xiaoxufeifei/ECG-acquisition-circuit-NJU-ee-project/ECG_AFE_可行性设计.md

# 心电信号放大电路：任务识别、可行性设计与验收方案

## 1. 图片中的任务要求

任务是设计并制作一套心电信号模拟前端，滤除心电频带以外的干扰，把微弱差模心电信号送入 0–3.3 V 单片机 ADC。硬性指标如下：

- 输入阻抗：不低于 5 MΩ；
- 共模抑制比：不低于 80 dB；
- 频带：0.2–90 Hz；低端低于 0.2 Hz 可加分，最低计到 0.05 Hz；高端允许误差 ±5%；
- 差模增益：1500 倍；
- 芯片只能选 OP07、LM358、TL084；
- 运放单元不超过 12 个，滑动变阻器不超过 4 个；
- 需要 50 Hz 陷波器，要求 3<Q<3.5；
- 输出要加直流偏置后送入 0–3.3 V ADC；
- 右腿驱动属于加分设计；
- R、C 都必须选标称值，不能直接填写计算所得的任意数值；电容不大于 1 µF；先选电容、再计算电阻；非标称电阻用标称电阻串、并联实现；
- 除电源电压外，1.65 V 等所有偏置电压都必须由板上相应电路产生，不能另接外部直流源；
- 高通必须放在仪用放大器之后，用于隔离电极极化电压；
- 先弄清原理再计算；仿真验收项目明确包括输入阻抗、差模增益和带宽。之后完成原理图和 PCB、设计验收、制板、焊接调试、信号源及心电模拟器实物验收；必须先通过设计验收再投板。课件原文为“10 月 16 日一阶段结束”（结合 2026-8-28 页脚可推定为 2026 年，但该页未单独写年份）。

## 2. 可行性结论与边界

从指标和允许器件看，任务具有可行性。以下是进入 EDA 前的可行性草案：采用 ±15 V 模拟电源和单片机的 3.3 V 电源，使用 11 个运放单元、4 个多圈微调电阻。10 Hz 端子到输出增益可校准为 1500.000，计算的整体 -3 dB 频带为 0.176–90.425 Hz，50 Hz 陷波 Q 为 3.252。OP07 的输出摆幅等关键指标在 ±15 V 条件下有数据手册保证；在完成厂商宏模型仿真、极限工况分析和教师设计验收前，本草案不能直接投板。

总增益 1500 与 0–3.3 V 范围共同决定了输入幅度上限。输出以约 1.65 V 为中心时，理论无削顶差模输入为 ±1.10 mV；考虑失调和容差，建议验收时把心电模拟器峰值限制在 ±1.00 mV以内。若模拟器幅度更大而又必须保持 1500 倍，0–3.3 V 输出必然削顶，这是指标本身的数学边界，不是换一种电路就能消除的。

本方案只用于隔离信号源和心电模拟器。它没有医疗隔离、除颤保护和患者漏电流认证，不能直接连接人体。

## 3. 总体信号链

```text
LA/RA 输入
  │  每路 100 kΩ 限流、10 MΩ 偏置；两路之间 47 pF 差模射频电容
  ▼
三 OP07 仪用放大器，Ad = 25
  ▼
820 nF + 1.1 MΩ 高通，fc = 0.176 Hz
  ▼
TL084 同相可调增益，A ≈ 23.58
  ▼
两运放 Fliege 50 Hz 陷波，Q = 3.252，A = 1
  ▼
四阶 Butterworth Sallen-Key 低通
  ├─ 第 1 节：Q = 0.5405，K = 1.15
  └─ 第 2 节：Q = 1.3158，K = 2.24
  ▼
OP07 电平抬升：VADC = VAC + VREF
  ▼
4.7 kΩ 隔离 + 3.3 V/0 V 钳位 + 10 nF ADC 储能电容
```

首级两路输出的平均共模同时送入独立 OP07 右腿驱动；3.3 V 经微调分压及 OP07 缓冲生成 VREF。

## 4. 运放与微调数量

| 器件 | 单元用途 | 单元数 |
|---|---|---:|
| OP07 ×3 | 三运放仪放 | 3 |
| TL084 ×1 | 高通后增益、Fliege 两单元、低通第 1 节 | 4 |
| OP07 ×2 | 低通第 2 节、ADC 电平抬升 | 2 |
| OP07 ×1 | 1.65 V 可调参考缓冲 | 1 |
| OP07 ×1 | 右腿驱动 | 1 |
| **合计** |  | **11** |

四个微调器分别用于 CMRR、总增益、50 Hz 中心频率和 ADC 静态中心电压，恰好不超过限制。

课件写的是“芯片范围：OP07、LM358、TL084”，即只能从三类中选，并未要求三类都要使用。LM358 曾作为后级候选，但 ±15 V 双电源已经等于它的 30 V 总工作电压上限，无法覆盖电源正向容差；其失调和 CMRR 也弱于 OP07。因此最终不用 LM358，以两个 OP07 代替，单元总数不变且可以统一供电。

## 5. 逐级电路及元件值

### 5.1 电源、地与输入保护

- OP07 和 TL084 都由 ±15 V 供电；Multisim 还要覆盖 ±5% 电源变化。最终 OP07 输出正常工作在 0.15–3.15 V 附近，远离两条供电轨，不依赖轨到轨能力。
- 每个 IC 的正、负电源脚各放一个 100 nF 陶瓷电容到模拟地，距离引脚尽量小于 5 mm；板上电源入口每条电源轨再放 1 µF，所有电容均不超过 1 µF。课件说明实验室提供的 1 µF 及以上电容均为有极性电解电容，因此这里的 1 µF 必须按有极性器件处理：+15 V 侧正端接 +15 V、负端接地；-15 V 侧正端接地、负端接 -15 V，原理图和 PCB 都必须标出极性。
- LA、RA 各串 100 kΩ 后进入仪放；每个运放正输入接 10 MΩ 到模拟地；两个 100 kΩ 之后的输入节点之间接一只 47 pF C0G/NP0。不要各自对地放射频电容，因为两只小电容的失配会直接把共模变成差模。
- 两只 100 kΩ 使用实验室清单中的 0.1% 精密电阻，但不能只凭“0.1%”标称就视为已经配对：焊接前仍须实测筛选，使两只 100 kΩ 的相对误差不大于 0.05%。清单没有 10 MΩ 精密值，因此两只 10 MΩ 保留同批次低温漂金属膜并同样实测筛选，成对相对误差不大于 0.05%；若现有测量条件不能可靠完成 10 MΩ 配对，应另行采购匹配件，不能用大量 100 kΩ 串联代替。在 90 Hz、另一输入交流接地的保守测量条件下，每个端口的输入阻抗约 9.7 MΩ，仍明显高于 5 MΩ。
- 四个输入电阻完全镜像布置，47 pF 跨接在两路节点之间且走线尽量短。这个匹配条件是板级 CMRR 的组成部分，不能只依赖 OP07 自身的 CMRR。

### 5.2 三 OP07 仪用放大器

本节改用老师提供的 0.1% 精密电阻库存。以下只使用贴片和直插清单中都具备的 10 kΩ、30 kΩ；同一组匹配网络必须统一使用同一种封装，不能把 0805 与直插混装。

前两个 OP07 构成经典仪放输入级：

- 两个反馈电阻各使用一只 30.0 kΩ、0.1% 精密电阻；
- 两个反相端之间的增益电阻由四只 10.0 kΩ、0.1% 精密电阻并联，等效为 2.50 kΩ；四只器件应靠近、等长连接；
- 输入级差模增益：

```text
Rg = 10 kΩ || 10 kΩ || 10 kΩ || 10 kΩ = 2.50 kΩ
A1 = 1 + (30 kΩ + 30 kΩ) / 2.50 kΩ = 25
```

第三个 OP07 构成标称单位增益差分放大器：

- 定义 R1 为前级输出到反相端、R2 为输出到反相端反馈、R3 为另一路前级输出到同相端、R4 为同相端到地；R1、R2、R3、R4 的固定部分全部使用 10.0 kΩ、0.1% 精密电阻；
- `P_CMRR` 仍为 200 Ω 十圈微调器，作为变阻器串在 R4 与地之间。焊接前实测四只 10 kΩ 并按 `Ra≤Rb≤Rc≤Rd` 排序：R4 固定部分用 Ra、R3 用 Rb、R1 用 Rc、R2 用 Rd。由 `R4总值=R3×R2/R1` 可知所需补偿为非负值；对 0.1% 的 10 kΩ，理论补偿量不超过 20 Ω，因此 0–200 Ω 的上限足够。初次上电先把 `P_CMRR` 调到接近最小值；
- 200 Ω 微调器实际可能存在非零端电阻。焊接前要测出其可达下限，并通过重选或调换四只 10 kΩ，使计算出的补偿量落在实际可调区间内；若调到下限后实测 CMRR 已达标，则不必追求数学上的绝对 0 Ω。在线调 CMRR 时，万用表应能分辨数欧姆以内的变化；
- 微调器作变阻器使用时，滑臂必须与相邻端短接，避免滑臂瞬断使环路开路。

OP07 的低失调、低漂移和高 CMRR 适合这一位置。精密电阻替换后，理想输入级增益仍为 25；`P_CMRR` 调节的是 `R4总值/R3=R2/R1`，从而使两臂比例相等并抑制共模，而不是把差模增益强制调成 1。名义差模增益为 1，按上述排序后的实物差模增益 `R2/R1` 约为 1～1.002，残余总增益误差由后级 `P_GAIN` 校准，因此标称频响结构不变。30 kΩ/2.5 kΩ 相比原 12 kΩ/1 kΩ 把阻抗尺度提高了 2.5 倍，会略增加电阻热噪声和偏置电流造成的输出误差；最终仍须在厂商宏模型和短路输入噪声测试中复核。输入级增益 25 也会把末级差分电阻的残余共模误差折算降低约 28 dB。仪放输出之后才进入高通，符合课件要求。

> 本轮按要求只更新第 5 章原理图。第 2、3 章摘要、第 6 章及其后的验证结果、验证脚本仍保留旧电阻模型，不能视为对本替换方案的重新仿真结论；投板前应另行同步模型并复跑验证。

### 5.3 0.176 Hz 高通与可调增益

- 仪放输出串 820 nF、2% 薄膜电容；
- 电容后节点接 1.10 MΩ、1% 到模拟地，并接 TL084 的同相输入。该阻值不在精密库存内；若用库存值实现需要串联 11 只 100 kΩ，焊点、漏电和寄生风险大于精度收益，因此这里保留一只普通 1% 电阻；
- 低端截止频率：

```text
fL = 1 / (2π × 1.10 MΩ × 820 nF) = 0.1764 Hz
```

- TL084 反相端接库存中的 10.0 kΩ、0.1% 精密电阻到地；反馈固定部分为三只精密电阻 `100 kΩ + 100 kΩ + 20 kΩ = 220 kΩ`，再串联一只普通 3.00 kΩ、1% 电阻和 5 kΩ 十圈微调器 `P_GAIN`。3 kΩ 只占反馈总值约 1.3%，其误差由总增益校准吸收，没有必要用大量精密电阻并联去凑 3 kΩ；
- 采用下述新陷波参数后，`P_GAIN` 标称先调到约 2.80 kΩ；最终仍以 10 Hz 实测为准，使端子到输出的整机增益为 1500。此级标称增益：

```text
A2 = 1 + (220 kΩ + 3 kΩ + 2.80 kΩ) / 10 kΩ ≈ 23.580
```

TL084 的 JFET 输入使 1.1 MΩ 高阻节点上的偏置电流误差远小于双极型运放。0.176 Hz 的名义值为电阻、电容容差留出了裕量，使最坏样本仍不越过 0.2 Hz。

### 5.4 两运放 Fliege 50 Hz 陷波器

这里采用 TI 应用笔记 SLOA096 的 Fliege 拓扑，而不用元件匹配敏感的 Twin-T。定义输入为 `VIN_N`，输出为 `VNOTCH`，中间节点为 `N1`、`N2`、`N3`、`N4`：

- `VIN_N` 到 `N1`：100 nF、1% 薄膜电容与 200 kΩ 并联；200 kΩ 由两只同封装的 100 kΩ、0.1% 精密电阻串联；
- `N1` 到地：同样使用两只 100 kΩ、0.1% 精密电阻串联成 200 kΩ；两组 200 kΩ 网络应同批、同布局，并在焊接前测量配对；
- `N1` 到 `N2`：31.8 kΩ，由一只 30 kΩ、0.1% 精密电阻和一只普通 1.8 kΩ、1% 电阻串联；
- TL084-B：同相端接 `N1`，反相端接 `N3`，输出为 `VNOTCH`；
- `N2` 到 `N3`：100 nF、1% 薄膜电容；
- `N3` 到 `VNOTCH`：一只 30 kΩ、0.1% 精密电阻串 10 kΩ 十圈微调器 `P_NOTCH`；标称先把微调器调到约 1.86 kΩ，使总值约为 31.862 kΩ；
- `VNOTCH` 到 `N4`：100 kΩ、0.1%；`VIN_N` 到 `N4`：100 kΩ、0.1%；
- TL084-C：同相端接 `N4`，反相端接 `N3`，输出接 `N2`。

名义参数为：

```text
f0 = 1 / (2π × √(31.8 kΩ × 31.862 kΩ × 100 nF × 100 nF)) ≈ 50.000 Hz
Q  ≈ 200 kΩ / (2 × √(31.8 kΩ × 31.862 kΩ)) ≈ 3.142
```

Fliege 拓扑比 Twin-T 更容易调节，但并不意味着元件失配不重要：C1、C2 采用 1% 薄膜并筛选到相对误差最好不大于 0.2%；两组 200 kΩ 和两只 100 kΩ 使用库存精密电阻并配对。1.8 kΩ 可以保留普通 1%，因为 `P_NOTCH` 能补偿它造成的中心频率偏差。`P_NOTCH` 在实物上用 50 Hz 正弦信号调到输出最小；它不能同时消除全部电容失配、有限开环增益和 PCB 寄生造成的残余。新标称 Q≈3.142，仍满足严格的 `3<Q<3.5`，且不增加微调器数量。

### 5.5 四阶 90 Hz Butterworth 低通

两节均采用等 R、等 C、非反相 Sallen-Key。每节的连接方式为：输入经 R1 到节点 A，再经 R2 到运放同相端节点 B；C1 从节点 A 接运放输出，C2 从节点 B 接地。低 Q 节放在前面，避免高 Q 节先产生内部峰值而降低过载裕量。

两节的频率网络共同采用：

- R1 = R2 = 17.4 kΩ、1% 普通电阻，不强行用三只精密电阻拼成每一个等效值。焊接前在同一温度下筛选四只标称 17.4 kΩ，使实测值都落在 17.43–17.47 kΩ；每节的 R1、R2 相对误差不大于 0.1%。若用 15 kΩ + 2.4 kΩ 串联，则按串联后的总阻值执行同一筛选窗口。若万用表不能可靠完成这一筛选，则四个位置统一改用 `10 kΩ + (10 kΩ || 30 kΩ) = 17.5 kΩ` 的精密组合并重新复核，不能把未筛选的 1% 电阻直接当成已验证方案；
- C1 = C2 = 100 nF、1% 薄膜；
- 按筛选中心 17.45 kΩ 计算，自然频率约为 `f0=91.206 Hz`。两节级联并计入新陷波器后，标称整机高端 -3 dB 点约为 90.08 Hz；不能把每一节的自然频率误当成整机截止频率。

第 1 节使用 TL084-D：

- 反相端到地使用直插 50 kΩ、0.1% 精密电阻；反馈用直插 `10 kΩ || 30 kΩ = 7.50 kΩ`、0.1% 精密电阻组合；
- `K1 = 1.15`，`Q1 = 1/(3-K1) = 0.5405`。

第 2 节使用 OP07：

- 反相端到地使用直插 50 kΩ、0.1% 精密电阻；反馈用直插 `30 kΩ + 20 kΩ + (20 kΩ || 30 kΩ) = 62.0 kΩ`、0.1% 精密电阻组合；
- `K2 = 2.24`，`Q2 = 1/(3-K2) = 1.3158`。

这两个 Q 与原方案相同，仍接近四阶 Butterworth 的 0.5412 和 1.3066。这里只把决定 K、进而决定 Q 的电阻比改成库存精密组合；四只 17.4 kΩ 频率电阻保留普通 1% 并筛选，避免把 4 只单电阻膨胀为 12 只精密组合电阻。按上述筛选窗口、精密增益电阻 ±0.1% 和 100 nF 电容 ±1% 做理想运放端点复核，高端 -3 dB 约为 88.66–94.05 Hz，仍位于 85.5–94.5 Hz 范围内。50 kΩ 只在直插精密库存中，不能把它直接换成贴片 51 kΩ 而不重新计算。增益网络阻抗约为原方案的 5 倍，运放负载更轻，但偏置电流误差和电阻噪声会增加，仍须用 OP07/TL084 厂商宏模型复核。

### 5.6 参考电压、电平抬升和 ADC 保护

- 10 kΩ 十圈微调器 `P_OFFSET` 跨接 3.3 V 和地，滑臂接 OP07 电压跟随器，得到可调 `VREF`；滑臂对地加 100 nF。
- 正常起调值为 1.65 V；短接两个信号输入后，用它把最终输出调到 1.65 V，从而同时补偿前级残余失调。
- 低通输出 `VAC` 和 `VREF` 各经 20.0 kΩ、0.1% 接末级 OP07 同相端；该 OP07 反相端接 10.0 kΩ 到地、10.0 kΩ 反馈。

因此：

```text
V+    = (VAC + VREF) / 2
VADC  = 2V+ = VAC + VREF
```

10 Hz 的端子到输出交流增益为：

```text
|Hin|       = 0.990099   （100 kΩ、10 MΩ、47 pF 输入网络）
|HHP|       = 0.999844
|Hnotch|    = 0.997958
|HLP1|      = 1.140266
|HLP2|      = 2.259123
Ad(10 Hz)   = 0.990099 × 25 × 23.577 × 0.999844 × 0.997958
              × 1.140266 × 2.259123 ≈ 1500
```

最终仍以 10 Hz 实测为准调 `P_GAIN`，使 `Ad(10 Hz)=1500`；不能只乘各级的直流/渐近增益，因为那会漏掉输入保护网络和滤波器的实际幅值。

末级 OP07 输出先串 4.7 kΩ，再到 ADC 引脚；ADC 引脚用低漏电 Schottky 二极管分别钳位到 0 V 和 3.3 V，并接 10 nF 到地。4.7 kΩ 隔离了 ADC 采样电容和运放输出，10 nF 形成的极点约 3.39 kHz，对 90 Hz 幅频几乎无影响。

### 5.7 右腿驱动

- 两个仪放输入级输出各经 1.00 MΩ 接 OP07 反相端；
- 同相端接模拟地；
- 反馈为 1.00 MΩ 与 1 nF 并联；
- 输出再串 1.00 MΩ 接心电模拟器的 RL 端。

低频下该级对输入共模近似为 -2 倍反馈，1 nF 使反馈在约 159 Hz 以上滚降，输出串联 1 MΩ 隔离电极/线缆电容，有利于环路稳定。该端只接模拟器，不接人体。

## 6. 计算与容差验证结果

复核脚本为 `ecg_afe_verify.py`，频响图为 `ECG_AFE_frequency_response.png`。脚本使用理想运放的精确节点方程验证拓扑，并对电阻、电容容差做 600 次固定随机种子的蒙特卡洛分析。

名义结果：

| 项目 | 结果 | 要求 |
|---|---:|---:|
| 10 Hz 端子到输出增益 | 1500.000 V/V，校准误差 0 | 1500 V/V |
| 低端 -3 dB | 0.1761 Hz | 不高于 0.2 Hz |
| 高端 -3 dB | 90.425 Hz | 85.5–94.5 Hz |
| 50 Hz 陷波 Q | 3.252 | 严格满足 3<Q<3.5 |
| 未微调、标准名义值在 50.000 Hz 的衰减 | 约 47.85 dB | 课件未规定衰减量 |

容差模型采用高通 R±1%/C±2%、关键增益及滤波电阻 ±0.1%、100 nF 电容 ±1%、47 pF 电容 ±5%，并在每个样本中调节 `P_NOTCH` 和计算从 LA/RA 端子开始的 `P_GAIN`：

| 项目 | 600 次结果范围 |
|---|---:|
| 低端 -3 dB | 0.1712–0.1812 Hz |
| 高端 -3 dB | 88.10–92.70 Hz |
| 陷波 Q | 3.213–3.283；600/600 个样本均得到有效交点 |
| 50 Hz 调谐所需 R4 | 31.246–32.516 kΩ，位于 27–37 kΩ 可调范围内 |
| 1500 倍调谐所需 `P_GAIN` | 1.923–3.566 kΩ，600/600 个样本均位于 0–5 kΩ 范围内 |
| 调谐后 50 Hz 陷波深度 | 中位数约 67.79 dB；95% 样本衰减至少约 58.89 dB |
| 输入保护/偏置网络自身 CMRR | 随机样本最小 100.25 dB、5% 分位 102.49 dB；边界枚举最坏 100.07 dB |

随机样本的最小/最大值不是数学最坏界，因此另做确定性边界检查：

- 高通 R、C 同时取使截止频率最高的容差端点时，单级极点为 0.1819 Hz，仍低于 0.2 Hz；
- 两节低通的四只 R、四只 C 和四只增益电阻共 12 个容差变量做全部 4096 个端点组合，高端 -3 dB 为 87.327–93.306 Hz，全部处于 85.5–94.5 Hz；
- 把端子输入网络、仪放和后增益电阻的合法端点纳入增益灵敏度复核，`P_GAIN` 需求约为 1.34–4.21 kΩ，0–5 kΩ 仍有余量。

这些是理想运放拓扑和元件容差结果，不包含有限开环增益、GBW、输入偏置电流、输出摆幅、压摆率及饱和恢复，因此不代替 Multisim 中 OP07/TL084 厂商宏模型的最终仿真。实物陷波深度还会受 PCB 泄漏、地回流、寄生参数和信号源失真限制。必须通过厂商宏模型的 AC、瞬态、温度、电源与 Monte Carlo 门禁后再提交设计验收，验收通过后才能投板。

## 7. CMRR、摆幅与稳定性论证

### 输入阻抗和 CMRR

- 两只 10 MΩ 偏置电阻决定低频输入阻抗；47 pF 只跨在差分输入之间，不承受理想共模电压。90 Hz 时按另一输入交流接地计算，每个端口约 9.7 MΩ，留有明显裕量。
- OP07 数据手册的低频 CMRR 最小值为 100 dB；仪放输入级的 25 倍差模增益进一步减小差分级比例误差的输入折算影响。
- 在低阻抗共模信号源、两组输入电阻成对匹配不大于 0.05% 的假设下，脚本单独检查保护/偏置网络引入的共模转差模；这只是板级 CMRR 的必要条件，不等于整机 CMRR。
- 差分级采用对称走线、比值匹配网络并保留 `P_CMRR`，设计目标应定为实测不低于 90 dB，而不只卡在 80 dB 边缘。
- 右腿驱动降低进入仪放的实际工频共模，但 CMRR 验收应先关闭或断开右腿驱动，避免把闭环抑制误当成仪放本身的 CMRR。

### 前端噪声

- 对实验室低输出阻抗信号源，前端主要可计算噪声来自两只 100 kΩ 输入限流电阻和两个 OP07。25°C 时每只 100 kΩ 电阻约 40.7 nV/√Hz，两路差分约 57.6 nV/√Hz；再按 OP07 在 100 Hz 的最大电压噪声 13.5 nV/√Hz 两路合成，约为 60.7 nV/√Hz。
- 在约 0.2–90 Hz 内按白噪声粗略积分，等效输入噪声约 0.58 µV rms，乘 1500 后约 0.87 mV rms，远小于 ±1.5 V 有效输出。实际电极的接触阻抗、运动伪差、OP07 电流噪声和 1/f 噪声会增加该数值，最终必须用心电模拟器和短路输入实测。
- 10 MΩ 偏置电阻的热噪声在低输出阻抗信号源下会被信号源阻抗旁路；若电极或信号源阻抗很高，噪声会明显上升，因此两电极阻抗应尽量低且匹配。

### 摆幅和动态性能

- ±1.0 mV 心电信号经仪放后只有 ±25 mV，经全部增益后约 ±1.50 V；±15 V 模拟电源留有充足交流摆幅。
- 90 Hz、1.5 V 峰值所需压摆率约 0.00085 V/µs，远低于所选 OP07、TL084 的能力；带宽限制来自设计的 RC，而不是运放 GBW 或压摆率。
- 电极差分极化电压会先被 25 倍放大，再由高通隔离。若模拟器带有 ±300 mV 差分直流，仪放内部输出可能达到 ±7.5 V；±15 V 条件下 OP07 的数据手册输出摆幅指标覆盖这一量级。更大的差分直流必须先减小，否则首级会饱和且高通无法事后挽救。

### 稳定性和 PCB

- 四阶低通把低 Q 节放在高 Q 节之前，降低内部节点峰值。
- 不把大电容直接并在运放输出；ADC 电容前串 4.7 kΩ，右腿线前串 1 MΩ。
- ADC 钳位二极管会在模拟电源已上电而 3.3 V 尚未上电时反向给单片机供电；实验时应让 3.3 V 先上电、后断电，或增加专用限流/电源时序，不能只依赖 MCU 内部钳位。
- 输入区远离数字时钟、DC/DC、电源线和 50 Hz 变压器；LA/RA 两路完全镜像，差分电阻网络紧贴第三个 OP07。
- 模拟地采用连续地平面；ADC 地回流、右腿驱动回流和前端输入偏置回流不要串行共用细长走线。
- 高阻节点保持清洁，焊剂必须彻底清洗；100 nF/820 nF 优先使用 C0G、聚丙烯或稳定薄膜，避免高介电常数电容的电压系数和温漂。
- `47 pF、1 nF、10 nF、100 nF、820 nF、1 µF` 都是标称电容值；`9.90 kΩ、12.4 kΩ、17.4 kΩ` 属 E96 标称电阻，但投板前仍应核对实验室库存，没有单值时按文中串联组合实现。
- OP07、TL084 的封装和引脚必须按实际订购后缀重新核对，尤其不要把 OP07 的失调调零脚误当作空脚；未使用的芯片引脚也不能悬空误接。

## 8. Multisim 与实物验收步骤

1. **静态工作点**：短接 LA/RA 并接地，检查所有 ±15 V 级无饱和；调 `P_OFFSET` 使 `VADC=1.650 V`。
2. **输入阻抗**：分别在每个输入串已知测试电阻，用 10 Hz 和 90 Hz 小信号测分压，确认每路大于 5 MΩ。
3. **仪放差模增益**：在两个输入施加反相的 10 Hz 小信号，测仪放输出，确认约 25 倍。
4. **CMRR 调整**：断开右腿驱动，两个输入同时加 50 Hz、100 mV 共模，在仪放输出、高通/陷波器之前测量并调 `P_CMRR` 使残差最小；再由 `20log10(Ad/Acm)` 计算，目标不低于 90 dB。随后在相同测点复测 10 Hz 和 90 Hz；若教师规定了幅度或频率，以教师口径为最终验收条件。不能在 50 Hz 陷波器之后测量，否则会把陷波衰减误算成 CMRR。
5. **50 Hz 调整**：输入 50.000 Hz 差模小信号，调 `P_NOTCH` 使陷波输出最小；扫频找相对于邻近通带增益的两个 -3 dB 交点，并计算 `Q=f0/(fH-fL)`，确认严格满足 `3<Q<3.5`。
6. **总增益**：输入 10 Hz、1.000 mVpp 差模信号，调 `P_GAIN` 使最终交流输出为 1.500 Vpp；测量时去掉 1.65 V 直流分量。
7. **整体扫频**：扫 0.02–300 Hz，相对 10 Hz 增益寻找低、高端 -3 dB 点；50 Hz 陷波点单独记录，不把它误判为通带截止点。
8. **容差与模型**：Multisim 使用厂商宏模型，运行至少 200 次 Monte Carlo；同时做 ±15 V 电源 ±5%、温度、器件偏置/失调和关键电容容差分析，并检查每级峰值与饱和恢复。
9. **过载恢复**：叠加差分直流偏置，确认首级不饱和；断开再接回模拟电极，记录基线恢复时间。
10. **实物验收**：先信号源、后心电模拟器；依次重复静态中心、增益、频带、50 Hz 陷波和 CMRR，最后才接 ADC。

## 9. 调试顺序

严格按以下顺序可以减少四个微调器之间的相互影响：

1. `P_OFFSET`：输入短路，调输出中心；
2. `P_CMRR`：同相信号输入，调共模残差最小；
3. `P_NOTCH`：50.000 Hz 输入，调陷波最深；
4. `P_GAIN`：10 Hz 差模输入，调总增益 1500；
5. 回查输出中心、0.2 Hz、90 Hz 和 50 Hz；必要时只做一轮小幅复调。

## 10. 参考资料

- [TI: More Filter Design on a Budget, SLOA096](https://www.ti.com/lit/an/sloa096/sloa096.pdf)——Fliege 陷波器原理图及 `f0`、`Q` 公式；
- [TI: Three-op-amp instrumentation-amplifier CMRR note](https://www.ti.com/lit/an/sboa014/sboa014.pdf)——三运放仪放与差分电阻匹配；
- [TI: Sallen-Key low-pass design resource](https://www.ti.com/tool/CIRCUIT060054)——二阶 Butterworth Sallen-Key；
- [TI: Discrete single-lead ECG signal conditioning](https://www.ti.com/video/6269751746001)——离散 ECG 前端与右腿驱动；
- 工作区中的 `OP07.PDF`、`TL084.PDF`、`LM158.PDF`——实际允许器件的电气限制和封装资料。
