xiaoxufeifei/ECG-acquisition-circuit-NJU-ee-project/(list of files, drawings)

Other design files:
Design1.ms14
